rusk2ua/remkey/docs/remote-access-tailscale-nordvpn.md

# Remote access with Tailscale while NordVPN stays on

How to reach the shack PC from the road with **Tailscale**, while **NordVPN** keeps
running on the shack PC full time. It covers the shack PC (Windows 10), the Macs
and the iPad.

Short version:

- **AnyDesk** stays as the screen, keyboard and audio path. It already handles the
  shack PC's two displays and the 7610's USB audio, and nothing else here does that
  better.
- **Tailscale** carries remkey (TCP 7373) and gives you a private backup path to the
  shack PC. It replaces the router port-forward (section 5, Option A) and the
  AnyDesk TCP tunnel (Option B).
- **NordVPN** stays connected on the shack PC, with a few settings changed
  (section 3). Tailscale runs *inside* the NordVPN tunnel; do **not** exclude the
  Tailscale service with NordVPN's split tunneling (it cuts Tailscale off).
- **On the Macs and the iPad, Tailscale and NordVPN can't run at the same time.**
  Disconnect NordVPN before you connect to the station (section 7).

---

## 1. How the pieces fit

```
 Mac (NordVPN OFF)                                   Shack PC (NordVPN ON)
 ┌──────────────────┐                                ┌──────────────────────────────┐
 │ remkey.client ───┼── Tailscale (WireGuard) ──────►│ tailscaled  ──► remkey.station│
 │                  │   100.x.y.z : TCP 7373         │  (rides inside the  port 7373│
 │                  │                                │   NordVPN tunnel)            │
 │ AnyDesk ─────────┼── AnyDesk (as today) ─────────►│ AnyDesk: 2 displays + audio  │
 └──────────────────┘                                │                              │
                                                     │ browsers, updates, etc. ──►  │
                                                     │   NordVPN tunnel (unchanged) │
                                                     └──────────────────────────────┘
```

Why this works: Tailscale only routes traffic for its own `100.64.0.0/10`
addresses and leaves everything else to NordVPN, so the two don't fight over
routes. Tailscale's own encrypted packets simply travel through the NordVPN tunnel,
and the outside world sees the shack PC at a NordVPN server address. NordVPN's NAT
is the friendly kind (`tailscale netcheck` shows `MappingVariesByDestIP: false`),
so peers can usually still connect directly, with a detour through the NordVPN
server, instead of falling back to Tailscale's relays.

**Tested and rejected: excluding `tailscaled.exe` with NordVPN split tunneling.**
It looks like the obvious fix, but on this PC (NordVPN Windows app, Oct 2026) the
exclusion only takes effect when the Tailscale service restarts, and from then on
the service can't reach anything: `tailscale status` shows it logged out, unable to
fetch the control key ("A socket operation was attempted to an unreachable
network"). NordVPN's per-app exclusion is built for desktop apps, not a service
running as SYSTEM. Removing `tailscaled.exe` from the list and restarting the
service fixed it.

A side effect worth knowing: with NordVPN on, the old router port-forward
(Option A) probably never worked reliably, because replies to inbound connections
leave through the NordVPN tunnel instead of the Spectrum line. Tailscale avoids
that problem entirely, since every connection is outbound from both ends.

---

## 2. Shack PC: install and set up Tailscale

Do this while you're at home, sitting at the shack PC.

1. Run the Tailscale installer you downloaded. Sign in with the same account you
   used to sign up.
2. In the Tailscale tray menu, open **Preferences** (newer builds call it
   **Settings**) and turn on **Run unattended**. Without this, Tailscale stops when
   you're logged out, and an unattended shack PC needs it running from boot.
3. Make sure **Use exit node** is **None**, and leave **Run exit node** off. An
   exit node can't coexist with NordVPN.
4. Open the admin console (<https://login.tailscale.com/admin/machines>) on any
   computer:
   - Rename the shack PC to something short, e.g. `shack` (**…** menu →
     **Edit machine name**).
   - **…** menu → **Disable key expiry**. Otherwise the shack PC drops off the
     tailnet after 180 days and you can't fix it from the road.
   - Note its `100.x.y.z` address. It doesn't change, so the clients use it
     directly.
5. In PowerShell (no admin needed):
   ```
   tailscale status
   tailscale ip -4
   ```
   `status` should list the shack PC and any other devices you've added.

Tailscale sets its adapter to the **Private** network category in Windows. If the
tray ever shows *"Failed to set the network category to private"*, restart
Tailscale, and check that `tailscaled.exe` is *not* in NordVPN's split tunneling
list (section 3).

---

## 3. Shack PC: NordVPN settings

Open the NordVPN app → the **gear icon** (bottom left) → work down the list below.
Names move between app versions; if a setting isn't where this says, use the search
box at the top of NordVPN's settings.

| Setting | Where (Windows app) | Set to | Why |
|---|---|---|---|
| VPN protocol | Settings → Connection | **NordLynx** (already) | Leave as is. |
| Auto-connect | Settings → Connection (or General) | **On**, "Always" / "On all networks" | NordVPN comes back by itself after a reboot. |
| **Meshnet** | Varies by version | **Off** (check it with PowerShell; see below) | Meshnet uses the same `100.64.0.0/10` address block as Tailscale. Both on = address conflict. |
| **Kill Switch** | Settings → Kill Switch | **Internet Kill Switch: Off.** App Kill Switch: optional (browsers only) | If NordVPN ever drops with the Internet Kill Switch on, it blocks *all* traffic, Tailscale and AnyDesk included, and you're locked out until someone is at the PC. |
| **Split tunneling** | Settings → Split tunneling | Off, or on **without `tailscaled.exe`** in the list | Excluding the Tailscale service cuts it off entirely (section 1). |
| Threat Protection / custom DNS | Settings → Threat Protection, Settings → Connection | Either is fine | Can stop Tailscale names (MagicDNS) resolving *on the shack PC*. Nothing here relies on that: the clients use the 100.x address. |
| Stay invisible on LAN / Allow LAN discovery | Settings → Connection (or General) | Either is fine | Affects your home LAN, not the tailnet. |

### Checking and turning off Meshnet

NordVPN keeps moving Meshnet's controls between app versions (the 2026 redesign
shows only file-transfer options on the Meshnet screen), so check the network
adapter instead of the app. In PowerShell:

```powershell
Get-NetIPAddress -AddressFamily IPv4 |
  Where-Object IPAddress -like '100.*' |
  Format-Table InterfaceAlias, IPAddress
```

- **No rows** (before Tailscale is installed), or **one row on the Tailscale
  adapter**: Meshnet is off. Nothing to do.
- **A row on a NordLynx/NordVPN adapter**: Meshnet is active. Find its
  disable option in the app (older versions: the dropdown arrow next to the
  Meshnet toggle on **Devices in Meshnet** → **Disable for this device**; in
  newer versions try the search box in Settings), then run the check again.

### Checking Tailscale after NordVPN changes

After changing NordVPN settings, restart the Tailscale service (PowerShell as
Administrator) and check that it's still connected:

```powershell
Restart-Service Tailscale     # can look stuck for a while; it usually isn't
Start-Sleep 15
tailscale status
```

You should see your devices, with the shack PC on its `100.x` address. If it says
**logged out** and mentions the control key or an unreachable network, NordVPN is
blocking the service: take `tailscaled.exe` out of NordVPN's split tunneling list,
then restart the service again.

To see the public addresses the service is using:

```powershell
(tailscale status --json | ConvertFrom-Json).Self.Addrs
```

With NordVPN connected you'll see a NordVPN server address, the NordLynx address
(`10.5.0.x`) and the LAN address. That's expected. (`tailscale netcheck` runs from
the CLI process, so it reports what the CLI sees, not necessarily the service.)

### Plan B: only selected apps use NordVPN (untested here)

If tailnet connections from the road turn out to be relayed (`via DERP(...)`) and
the extra latency matters, NordVPN's split tunneling has a second mode, **"Enable
VPN for selected apps only"**: only the apps you list (your browsers, for
example) go through NordVPN, and everything else (Tailscale, AnyDesk, N1MM+,
Windows Update) uses the fiber directly. That avoids per-app exclusion of the
Tailscale service entirely. Test it with the commands above, and run the remote
reboot test in section 9 before relying on it.

---

## 4. remkey over Tailscale

**Why Tailscale Serve:** with NordVPN connected, NordVPN's firewall on the shack
PC drops *inbound* TCP connections arriving on the Tailscale adapter (ping still
works, but a connection to a program listening on the 100.x address hangs).
Tested: a Windows Firewall rule allowing 7373 from the tailnet is not enough, and
disconnecting NordVPN makes it work immediately. Tailscale Serve gets around this:
the Tailscale service (`tailscaled`) accepts the connection itself, which NordVPN
allows, and hands it to remkey over localhost.

### Shack PC

1. In `station.toml`, listen on localhost only:
   ```toml
   listen_host = "127.0.0.1"
   listen_port = 7373
   ```
   Nothing on the LAN or the internet can reach the port directly; only Serve can.
2. Restart the station service (or the Task Scheduler task).
3. PowerShell **as Administrator**:
   ```powershell
   tailscale serve --bg --tcp 7373 tcp://127.0.0.1:7373
   tailscale serve status
   ```
   If it prints a link to enable Serve for your tailnet, open it, approve, and run
   the command again. `--bg` makes it permanent (it survives reboots). The status
   should show `tcp://100.x.y.z:7373 (tailnet only)` → `tcp://127.0.0.1:7373`.
4. Check who's listening:
   ```powershell
   Get-NetTCPConnection -LocalPort 7373 -State Listen |
     Select-Object LocalAddress, @{n='Process';e={(Get-Process -Id $_.OwningProcess).ProcessName}}
   ```
   Expect `127.0.0.1` → `python` and `100.x.y.z` → `tailscaled`.
5. No Windows Firewall rule is needed for 7373. If Windows created *Allow* rules for
   `python.exe` / `py.exe` when the station first ran, you can disable them
   (`wf.msc` → Inbound Rules, sort by Program).
6. If you set up a **router port-forward** for 7373 (README Option A), delete it.

To turn it off: `tailscale serve --tcp=7373 off`.

### Mac

In `client.toml`:
```toml
station_host = "100.x.y.z"   # the shack PC's Tailscale address from section 2
station_port = 7373
```
(The MagicDNS name also works when NordVPN is off on the Mac, but the address has
no DNS dependence at all.)

Bonus: the remkey link is now encrypted end to end by Tailscale (WireGuard), which
closes the "traffic isn't encrypted" note in `SECURITY.md`.

---

## 5. AnyDesk: keep it for screen and audio

AnyDesk stays the primary way to see and drive the shack PC:

- **Dual displays:** AnyDesk shows the shack PC's real displays as they are. Windows
  Remote Desktop (RDP) instead builds a new desktop sized to your Mac's screen, so
  N1MM+, GH Everyware and the 7610 display window get rearranged every time you
  connect.
- **Audio:** the 7610's USB audio → "Listen to this device" → AnyDesk audio path
  (README section 6, "Audio") is already set up. RDP is known to hide or upset radio
  audio devices; FlexRadio DAX and WSJT-X users report the radio's sound devices
  disappearing over RDP.

**Dropped sessions (`anynet_unknown` every few minutes):** this predates Tailscale
here; it happens with NordVPN on the shack PC. What helps:

1. On the shack PC, AnyDesk → **Settings → Connection** → unlock → **untick
   "Allow direct connections"**. Sessions then always go through AnyDesk's relays,
   which NordVPN doesn't interrupt.
2. Connect with **`/np`** after the ID (e.g. `123456789/np`), which also helped
   before.
3. Last resort, and only while you're at the shack PC: add AnyDesk to NordVPN
   split tunneling (bypass). Test it the same way as section 3, because excluding
   the Tailscale *service* this way cut it off completely, and AnyDesk also runs
   as a service.

Otherwise nothing in AnyDesk has to change; connect by AnyDesk ID as usual (tested working
alongside remkey over Tailscale). Connecting AnyDesk to the shack PC's Tailscale
address instead would hit the same NordVPN inbound block as remkey (section 4),
so don't bother unless you also route it through Serve
(`tailscale serve --bg --tcp 7070 tcp://127.0.0.1:7070` with AnyDesk's direct
connections enabled; untested).

---

## 6. Backup path: Remote Desktop over Tailscale (emergency only)

If AnyDesk itself breaks while you're away (crashed, updated badly, account
problem), Tailscale still gives you a way in:

- **Needs Windows 10 Pro.** Check with **Settings → System → About → Edition**.
  Windows 10 Home can't accept Remote Desktop connections.
- On the shack PC: **Settings → System → Remote Desktop → On**, and add your Windows
  user if asked. Restrict the built-in firewall rules to the tailnet:
  ```powershell
  Get-NetFirewallRule -DisplayGroup "Remote Desktop" |
    Set-NetFirewallRule -RemoteAddress 100.64.0.0/10,fd7a:115c:a1e0::/48
  ```
- With NordVPN connected, inbound RDP over Tailscale is blocked the same way remkey
  was (section 4). Either route it through Serve on a separate port
  (`tailscale serve --bg --tcp 13389 tcp://127.0.0.1:3389`, then connect to
  `100.x.y.z:13389`; untested), or disconnect NordVPN first (which needs AnyDesk,
  the thing that's broken in this scenario). Test this at home before relying on
  it.
- On the Mac or iPad: Microsoft's **Windows App** (formerly Remote Desktop) →
  add PC → the shack PC's 100.x address.
- Expect: the shack PC's local monitors lock, the window layout gets rearranged,
  and radio audio may not work. Use it to restart AnyDesk (or reboot), then go back
  to AnyDesk.

---

## 7. Macs (M4 Pro MBP, M3 Air)

1. Install Tailscale (Mac App Store or the standalone download from tailscale.com)
   and sign in with the same account.
2. **macOS can't run Tailscale and NordVPN together.** With NordVPN connected, new
   connections to tailnet addresses time out even though Tailscale says it's
   connected. Tailscale's maintainers treat this as a macOS limitation (one VPN at a
   time), not a bug that will be fixed.
3. So, to operate:
   1. **Disconnect NordVPN** (and turn off its auto-connect on the Macs, or it will
      reconnect on a new Wi-Fi network mid-session).
   2. Connect Tailscale.
   3. Start AnyDesk and `remkey.client`.
4. You give up nothing important on hotel or club Wi-Fi: the remkey link (Tailscale)
   and AnyDesk are both encrypted end to end. Only your *other* browsing loses
   NordVPN's cover while you operate.
5. If you want full-tunnel privacy *and* the tailnet at the same time, Tailscale's
   Mullvad exit-node add-on does that (paid, per 5 devices). It replaces NordVPN on
   the Mac rather than running alongside it. Not needed for station use.

## 8. iPad

iPadOS allows one VPN at a time, so it's Tailscale or NordVPN, never both. Since
you rarely run a VPN on the iPad, just install Tailscale and AnyDesk from the App
Store. remkey's client is Mac-only, so the iPad is for watching, tuning and
logging, not paddle CW.

---

## 8a. Other station software (N1MM+, GH Everyware, Slack)

Tailscale on the shack PC only adds routes for `100.64.0.0/10` and
`fd7a:115c:a1e0::/48`. Default internet traffic still goes through NordVPN, and
LAN traffic (`192.168.x.x`) still goes out the Ethernet adapter, so programs that
worked with NordVPN keep working:

- **Outbound internet clients** (Slack, cluster/telnet spots, callbook lookups,
  updates) are unchanged: still through NordVPN.
- **LAN and localhost** (N1MM+ to GH Everyware on 127.0.0.1, multi-computer N1MM+
  on the home LAN, the rotator controller) are unchanged.
- **Windows Firewall:** the only change is the disabled `python.exe` allow rules. If some *other* Python program on
  this PC accepts inbound connections from the LAN, give it its own rule.

What to check once, after a reboot:

1. `route print -4` → two `0.0.0.0` default routes: the NordLynx one
   (gateway `10.5.0.1`) with a much lower metric than the Ethernet one, so it
   wins. The Tailscale adapter (`100.x`) should only carry one `/32` route per
   tailnet peer plus `100.100.100.100` (MagicDNS), and no broadcast
   (`255.255.255.255`) or multicast (`224.0.0.0`) routes, so LAN broadcasts
   from N1MM+ never go near it.
2. **N1MM+**: if you use multi-computer networking or UDP broadcasts, confirm it's
   still using the LAN address (192.168.x.x), not the `100.x` Tailscale address.
   Programs that pick "the first network adapter" can grab the new one.
3. **GH Everyware** connects to the rotator and N1MM+ as before.

Adding remote computers later (a second N1MM+ station, a laptop in the field):
put them on the tailnet instead of opening ports on the router, and give N1MM+
their `100.x` addresses explicitly. Tailscale carries unicast traffic but not LAN
broadcasts, so anything that relies on broadcast discovery needs the address typed
in. If a Tailscale DNS setting ever interferes with name lookups,
`tailscale set --accept-dns=false` on the shack PC turns that part off without
affecting anything else.

## 9. Test before you leave home

Do these **at home**, with the Mac on the **phone hotspot** (not home Wi-Fi), so
you're testing the real path.

- [ ] Shack PC: NordVPN connected, `tailscale status` shows the Mac.
- [ ] Mac (NordVPN off): `tailscale ping 100.x.y.z` → replies. Ending
      `via <NordVPN server IP>:<port>` is direct (with the NordVPN detour);
      `via DERP(...)` means relayed: works, but slower (see Plan B, section 3).
      `tailscale ping` stops as soon as it finds a direct path, whatever `-c`
      says; add `--until-direct=false` to keep pinging.

      Measured here (Oct 2026, iPhone on cellular): with NordVPN connected on
      the shack PC, every ping went via DERP(nyc) at roughly 90–170 ms; with
      NordVPN disconnected it went direct at roughly 80–110 ms. So NordVPN does
      force the relay, but on cellular the difference is a few tens of ms,
      which doesn't matter for remkey.
- [ ] Mac: `nc -vz -w 5 100.x.y.z 7373` → `succeeded`, **with NordVPN connected
      on the shack PC**. A hang (timeout) means Serve isn't set up (section 4).
- [ ] Mac: `remkey.client` connects; the station log shows the login. Key with
      `--dry-run` on the station first.
- [ ] AnyDesk session works as before, both displays and audio.
- [ ] **Reboot the shack PC remotely** (Start → Restart from AnyDesk) and confirm
      that, without touching it, NordVPN reconnects, Tailscale comes back, the
      remkey task starts after login, and AnyDesk reconnects.
- [ ] Disconnect NordVPN on the shack PC briefly: Tailscale and AnyDesk should keep
      working (this proves the kill switch is off).
- [ ] Optional: Remote Desktop to the 100.x address works (section 6).

---

## 10. Troubleshooting

| Symptom | Likely cause | Fix |
|---|---|---|
| Mac: Tailscale "Connected", but nothing on the tailnet answers | NordVPN connected on the Mac | Disconnect NordVPN on the Mac (section 7). |
| `tailscale ping` works, `nc` to 7373 hangs/times out | NordVPN blocking inbound on the Tailscale adapter | Use Tailscale Serve (section 4); check `tailscale serve status`. |
| `nc` to 7373 is refused right away | Station service not running, or not on 127.0.0.1 | Check the station console/log and `Get-NetTCPConnection -LocalPort 7373`. |
| `tailscale ping` goes via DERP every time | NAT traversal through the NordVPN server failing | Works, just slower. If it matters, try Plan B (section 3). |
| Shack PC: `tailscale status` says logged out, "fetch control key … unreachable network" | `tailscaled.exe` excluded in NordVPN split tunneling | Remove it from the list, `Restart-Service Tailscale`. |
| Shack PC drops off the tailnet entirely | Key expiry, or Tailscale not running unattended | Section 2 steps 2 and 4. |
| Shack PC unreachable by anything after a NordVPN hiccup | Internet Kill Switch on | Turn it off (section 3). |
| Tailscale shows a Meshnet/address warning, or tailnet traffic goes nowhere | NordVPN Meshnet turned on | Turn Meshnet off. |
| Still unreachable with everything above checked | NordVPN's firewall blocking the tailnet anyway | Plan B in section 3 ("Enable VPN for selected apps only"). |

## What not to do

- Don't make the shack PC a Tailscale **exit node** or **subnet router**; both need
  their own aggressive routing that collides with NordVPN.
- Don't turn on NordVPN **Meshnet** on any device that runs Tailscale.
- Don't change Tailscale's address range or switch it to userspace mode to "fix"
  NordVPN; neither addresses the actual problem (NordVPN's firewall).

## References

- Tailscale: [Can I use Tailscale alongside other VPNs?](https://tailscale.com/kb/1105/other-vpns)
- Tailscale: [Windows network category message](https://tailscale.com/docs/reference/messages/client/set-network-category-failed)
- Tailscale issue [#21248](https://github.com/tailscale/tailscale/issues/21248): macOS tailnet TCP fails while NordVPN is connected
- NordVPN: [Split tunneling](https://support.nordvpn.com/hc/en-us/articles/19618692366865-What-is-Split-Tunneling-and-how-to-use-it)
- Home Assistant community: [Tailscale + NordVPN on Windows via split tunneling](https://community.home-assistant.io/t/accessing-ha-on-win11-with-both-nordvpn-and-tailscale-active/1010677)
- AnyDesk: [Client settings (direct connections)](https://support.anydesk.com/docs/settings)
