rusk2ua/remkey/host/remkey/station.py

"""remkey station service: runs on the shack PC next to N1MM+.

    python -m remkey.station --config station.toml

Accepts one authenticated client at a time and drives the station Nano:
text -> "T:", PTT -> "P:", speed -> "W:". If the client goes quiet or
disconnects, PTT is dropped and queued text is flushed. Independently, the
Nano's own watchdog drops PTT if this service stops talking to it.
"""

from __future__ import annotations

import argparse
import asyncio
import logging
import sys
import time
from collections import deque

from . import protocol as P
from .config import StationConfig, load_station
from .dashboard import Dashboard, Extremes, History
from .serial_link import BACK, LOST, FakeLink, KeyerLink, SerialLink
from .telemetry import (
    SRC_BASE,
    CableFit,
    Calibration,
    CsvLog,
    LinkStats,
    Packet,
    PowerPacket,
    ReplyAssembler,
    ReplyPart,
    gauge_match,
    parse_any,
)

log = logging.getLogger("remkey.station")


class Session:
    def __init__(self, reader: asyncio.StreamReader, writer: asyncio.StreamWriter):
        self.reader = reader
        self.writer = writer
        self.peer = writer.get_extra_info("peername")

    async def send(self, msg: dict) -> None:
        try:
            self.writer.write(P.encode(msg))
            await self.writer.drain()
        except (ConnectionError, RuntimeError):
            pass

    def send_nowait(self, msg: dict) -> None:
        try:
            self.writer.write(P.encode(msg))
        except (ConnectionError, RuntimeError):
            pass


class TelemetryHub:
    """Turns remtlm packets from the base Nano into calibrated readings and alerts.

    Two senders share the LoRa channel: the tower-top box ($RT, $RK and, if it has
    its own INA226, $RP) and the supply box at the tower base ($RS). Each has its
    own link statistics and stale alert.
    """

    def __init__(self, cfg: StationConfig, notify):
        self.cfg = cfg
        self.notify = notify                 # callable(dict): send to the client if connected
        self.pa_cal = Calibration(cfg.pa_cal)
        self.xv_cal = Calibration(cfg.xv_cal)
        self.stats = LinkStats()
        self.csv = CsvLog(cfg.tlm_csv) if cfg.tlm_csv else None
        self.latest: dict | None = None
        self.replies = ReplyAssembler()
        self.xv_replies: dict[str, dict] = {}     # "s"/"v" -> {"text", "time"}
        self.lock_ok = True
        self.hot = [False, False]
        self.stale = True
        names = list(cfg.temp_names) + ["probe 1", "probe 2"]
        self.temp_names = [str(names[0]), str(names[1])]
        self.pwr: PowerPacket | None = None          # latest top-box $RP, scaled
        self.pwr_time = 0.0
        self.box: PowerPacket | None = None          # latest supply-box $RS, scaled
        self.box_time = 0.0
        self.box_stats = LinkStats()
        self.box_stale = True
        self.box_hot = False
        self.fit = CableFit()                        # needs top-box voltage
        self.pwr_flags: dict[str, bool] = {}
        # for the web dashboard
        self.alerts: deque[dict] = deque(maxlen=200)
        self.on_alert = None                          # callable(dict), set by the dashboard
        self.extremes = Extremes()
        self.history = History(cfg.dash_history_h)
        self.history.pa_unit = "W" if self.pa_cal else "mV"
        if cfg.dash_port and cfg.tlm_csv:
            try:
                n = self.history.seed_from_csv(cfg.tlm_csv)
                if n:
                    log.info("dashboard: loaded %d rows of history from %s", n, cfg.tlm_csv)
            except (OSError, ValueError) as exc:
                log.warning("dashboard: could not read history from %s: %s", cfg.tlm_csv, exc)

    def on_line(self, line: str) -> None:
        p = parse_any(line)
        if isinstance(p, ReplyPart):
            self._on_reply(p)
            return
        if isinstance(p, PowerPacket):
            self._on_power(p)
            return
        if not isinstance(p, Packet):
            if line.startswith(("V:", "C:")):
                log.info("telemetry base: %s", line)
            elif line.startswith("E:"):
                log.warning("telemetry base: %s", line)
            return
        self.stats.update(p)
        pa_pk_w = self.pa_cal.watts(p.pa_pk_mv)
        pa_avg_w = self.pa_cal.watts(p.pa_avg_mv)
        top = self.pwr if (self.pwr is not None and self.pwr.seq == p.seq) else None
        box = self.box if (self.box is not None and not self.box_stale) else None
        self._csv(p, pa_pk_w, pa_avg_w, box or top, top if box else None)
        self.latest = {
            "t": "tlm",
            "seq": p.seq,
            "pa_pk_mv": p.pa_pk_mv,
            "pa_avg_mv": p.pa_avg_mv,
            "pa_pk_w": pa_pk_w,
            "pa_avg_w": pa_avg_w,
            "xv_pk_mv": p.xv_pk_mv,
            "xv_pk_w": self.xv_cal.watts(p.xv_pk_mv),
            "lock": p.lock,
            "temp_c": p.temp_c,
            "temp2_c": p.temp2_c,
            "temp_names": self.temp_names,
            "uptime_s": p.uptime_s,
            "loss_pct": round(self.stats.loss_pct_5min(), 1),
        }
        now = time.time()
        pa_pk = pa_pk_w if pa_pk_w is not None else p.pa_pk_mv
        pa_avg = pa_avg_w if pa_avg_w is not None else p.pa_avg_mv
        self.history.add_tower(now, pa_pk, pa_avg, p.xv_pk_mv, p.lock, p.temp_c, p.temp2_c)
        self.extremes.add("pa_pk", pa_pk)
        self.extremes.add("t1", p.temp_c)
        self.extremes.add("t2", p.temp2_c)
        if self.stale:
            self.stale = False
            self._alert("ok", "tower telemetry link up")
        if p.lock is not None and p.lock != self.lock_ok:
            self.lock_ok = p.lock
            self._alert("ok" if p.lock else "warn",
                        "10 MHz reference locked" if p.lock else "10 MHz reference UNLOCKED")
        for i, (t, warn) in enumerate(((p.temp_c, self.cfg.temp_warn_c),
                                       (p.temp2_c, self.cfg.temp2_warn_c))):
            if t is None:
                continue
            name = self.temp_names[i]
            if not self.hot[i] and t >= warn:
                self.hot[i] = True
                self._alert("warn", f"{name} HOT: {t:.1f} C")
            elif self.hot[i] and t < warn - 3:
                self.hot[i] = False
                self._alert("ok", f"{name} back to {t:.1f} C")
        self.notify(self.latest)

    # ------------------------------------------------------------ supply monitor
    def _csv(self, p, pa_pk_w, pa_avg_w, pwr, top) -> None:
        if not self.csv:
            return
        try:
            self.csv.write(p, pa_pk_w, pa_avg_w, pwr, top)
        except OSError as exc:
            log.warning("telemetry CSV: %s", exc)

    def _on_power(self, raw: PowerPacket) -> None:
        cfg = self.cfg
        p = raw.scaled(cfg.v_scale, cfg.i_scale)
        if p.src == SRC_BASE:
            self._on_box(p)
            return
        self.pwr = p
        self.pwr_time = time.time()
        self._flag("dead:top", not p.ok, "tower-top supply monitor (INA226) not answering",
                   "tower-top supply monitor answering again")
        if not p.ok:
            return
        self.history.add_top(self.pwr_time, p)
        self.extremes.add("top_v", p.v_min, p.v_max)
        self.fit.add(p.i_avg, p.v_avg)
        self._voltage_alerts(p, "tower-top supply", "top")
        if self.box is None or self.box_stale:       # the base box measures current when it's there
            self._current_alerts(p)
        self.notify(self.power_message())

    def _on_box(self, p: PowerPacket) -> None:
        cfg = self.cfg
        self.box_stats.update(p)
        self.box = p
        self.box_time = time.time()
        self.history.add_supply(self.box_time, p)
        self.extremes.add("box_temp", p.temp_c)
        if p.ok:
            self.extremes.add("v", p.v_min, p.v_max)
            self.extremes.add("i", p.i_min, p.i_max)
        if self.box_stale:
            self.box_stale = False
            self._alert("ok", "tower-base supply box link up")
        t = p.temp_c
        if t is not None and cfg.box_temp_warn_c:
            if not self.box_hot and t >= cfg.box_temp_warn_c:
                self.box_hot = True
                self._alert("warn", f"{cfg.box_temp_name} HOT: {t:.1f} C")
            elif self.box_hot and t < cfg.box_temp_warn_c - 3:
                self.box_hot = False
                self._alert("ok", f"{cfg.box_temp_name} back to {t:.1f} C")
        self._flag("dead:base", not p.ok, "tower-base supply monitor (INA226) not answering",
                   "tower-base supply monitor answering again")
        if self.stale:                               # no tower rows to ride on: log on our own
            self._csv(None, None, None, p, None)
        if not p.ok:
            return
        self._voltage_alerts(p, "supply at tower base", "base")
        self._current_alerts(p)
        self.notify(self.power_message())

    def _voltage_alerts(self, p: PowerPacket, where: str, key: str) -> None:
        cfg = self.cfg
        if cfg.v_min_alert:
            low = self.pwr_flags.get(f"low:{key}", False)
            self._flag(f"low:{key}", p.v_min < (cfg.v_min_alert + 0.2 if low else cfg.v_min_alert),
                       f"{where} LOW: {p.v_min:.2f} V (at up to {p.i_max:.2f} A)",
                       f"{where} back to {p.v_min:.2f} V")
        if cfg.v_max_alert:
            high = self.pwr_flags.get(f"high:{key}", False)
            self._flag(f"high:{key}", p.v_max > (cfg.v_max_alert - 0.2 if high else cfg.v_max_alert),
                       f"{where} HIGH: {p.v_max:.2f} V", f"{where} back to {p.v_max:.2f} V")

    def _current_alerts(self, p: PowerPacket) -> None:
        cfg = self.cfg
        if cfg.i_max_alert:
            on = self.pwr_flags.get("imax", False)
            self._flag("imax", p.i_max > (cfg.i_max_alert * 0.95 if on else cfg.i_max_alert),
                       f"tower current HIGH: {p.i_max:.2f} A peak (limit {cfg.i_max_alert:.2f} A)",
                       f"tower current back to {p.i_max:.2f} A peak")
        if cfg.i_min_alert:
            on = self.pwr_flags.get("imin", False)
            self._flag("imin", p.i_avg < (cfg.i_min_alert * 1.05 if on else cfg.i_min_alert),
                       f"tower current LOW: {p.i_avg:.2f} A (expected at least {cfg.i_min_alert:.2f} A)",
                       f"tower current back to {p.i_avg:.2f} A")

    def _flag(self, key: str, active: bool, warn_msg: str, ok_msg: str) -> None:
        was = self.pwr_flags.get(key, False)
        if active and not was:
            self.pwr_flags[key] = True
            self._alert("warn", warn_msg)
        elif not active and was:
            self.pwr_flags[key] = False
            self._alert("ok", ok_msg)

    def power_message(self, detail: bool = False) -> dict:
        """Supply summary for the client.

        Uses the base box when it is reporting, else the top-box INA226. With both,
        drop_v is measured (base minus top); with only the top box it is against
        base_supply_v from the config; with only the base box it is unknown (None).
        """
        now = time.time()
        box = self.box if (self.box is not None and not self.box_stale) else None
        top = self.pwr if (self.pwr is not None and now - self.pwr_time <= self.cfg.tlm_stale_s) else None
        p = box or top or self.box or self.pwr
        if p is None:
            return {"t": "pwr", "ok": False, "none": True}
        at = p.src
        msg = {"t": "pwr", "ok": p.ok, "at": at, "v_avg": p.v_avg, "v_min": p.v_min, "v_max": p.v_max,
               "i_avg": p.i_avg, "i_min": p.i_min, "i_max": p.i_max,
               "age_s": round(now - (self.box_time if p is self.box else self.pwr_time))}
        if at == SRC_BASE:
            ok_top = top is not None and top.ok
            msg.update({"base_v": p.v_avg, "top_v": top.v_avg if ok_top else None,
                        "drop_v": p.v_avg - top.v_avg if ok_top else None,
                        "box_temp_c": p.temp_c, "box_temp_name": self.cfg.box_temp_name,
                        "box_loss_pct": round(self.box_stats.loss_pct_5min(), 1),
                        "box_stale": self.box_stale})
        else:
            msg.update({"base_v": self.cfg.base_supply_v, "top_v": p.v_avg,
                        "drop_v": self.cfg.base_supply_v - p.v_avg})
        if detail:
            msg["query"] = True
            fit = self.fit.result()
            if fit:
                awg, exp, verdict = gauge_match(fit["r_ohm"], self.cfg.cable_one_way_ft)
                fit.update({"awg": awg, "expected_r": exp, "verdict": verdict,
                            "one_way_ft": self.cfg.cable_one_way_ft})
            msg["fit"] = fit
            msg["fit_points"] = len(self.fit.pts)
            msg["fit_possible"] = self.pwr is not None    # needs a top-box INA226
        return msg

    def _on_reply(self, rp: ReplyPart) -> None:
        done = self.replies.add(rp)
        if done is None:
            return
        cmd, text = done
        self.xv_replies[cmd] = {"text": text, "time": time.time()}
        log.info("transverter '%s' reply: %s", cmd, text.replace("\n", " | "))
        self.notify(self.xv_message(cmd))

    def xv_message(self, cmd: str) -> dict:
        r = self.xv_replies.get(cmd)
        if r is None:
            return {"t": "xvstat", "cmd": cmd, "text": None, "age_s": None}
        return {"t": "xvstat", "cmd": cmd, "text": r["text"], "age_s": round(time.time() - r["time"])}

    def check_stale(self) -> None:
        age = self.stats.age_s()
        if not self.stale and (age is None or age > self.cfg.tlm_stale_s):
            self.stale = True
            self._alert("warn", f"tower telemetry lost (no packet for {self.cfg.tlm_stale_s:.0f} s)")
        age = self.box_stats.age_s()
        if not self.box_stale and (age is None or age > self.cfg.tlm_stale_s):
            self.box_stale = True
            self._alert("warn", f"tower-base supply box lost (no packet for {self.cfg.tlm_stale_s:.0f} s)")

    def snapshot(self) -> dict | None:
        if self.latest is None:
            return None
        snap = dict(self.latest)
        snap["age_s"] = round(self.stats.age_s() or 0.0, 1)
        snap["stale"] = self.stale
        return snap

    def _alert(self, level: str, msg: str) -> None:
        (log.warning if level == "warn" else log.info)("telemetry: %s", msg)
        self.notify({"t": "alert", "level": level, "msg": msg})
        a = {"ts": time.time(), "level": level, "msg": msg}
        self.alerts.append(a)
        if self.on_alert:
            self.on_alert(a)

    def mark(self, text: str, peer: str = "") -> None:
        """A note from the dashboard ("starting TX test"): goes to the log, the alert list and the client."""
        log.info("dashboard marker from %s: %s", peer or "?", text)
        self._alert("info", f"MARK: {text}")


class StationService:
    def __init__(self, cfg: StationConfig, link: KeyerLink, tlm_link: KeyerLink | None = None):
        self.cfg = cfg
        self.link = link
        self.tlm_link = tlm_link
        self.tlm = TelemetryHub(cfg, self._notify) if tlm_link is not None else None
        self.session: Session | None = None
        self.ptt = False
        self.releasing = False          # PTT off requested; station finishing CW + hang
        self.wpm = 18
        self.server: asyncio.base_events.Server | None = None
        self._hb_task: asyncio.Task | None = None
        self.dashboard: Dashboard | None = None
        self.cloud = None
        link.set_handler(self._on_keyer_line)
        if tlm_link is not None:
            tlm_link.set_handler(self.tlm.on_line)

    # ------------------------------------------------------------ lifecycle
    def _init_keyer(self) -> None:
        self.link.send("G:1")          # make sure the Nano watchdog is armed
        self.link.send(f"J:{max(0, min(10000, int(self.cfg.ptt_hang_ms)))}")
        self.link.send("O")            # PTT off and nothing queued, right now
        self.link.send("V")

    async def start(self) -> None:
        self._init_keyer()
        self.server = await asyncio.start_server(
            self._handle_client, self.cfg.listen_host, self.cfg.listen_port, limit=P.MAX_LINE
        )
        self._hb_task = asyncio.create_task(self._keyer_heartbeat())
        addrs = ", ".join(str(s.getsockname()) for s in self.server.sockets)
        log.info("listening on %s", addrs)
        if self.cfg.dash_port:
            dash = Dashboard(self, self.cfg.dash_host, self.cfg.dash_port, self.cfg.dash_allow,
                             self.cfg.dash_hostnames)
            try:
                await dash.start()
            except OSError as exc:     # port in use etc.: keying must still come up
                log.error("dashboard not started on port %s: %s", self.cfg.dash_port, exc)
            else:
                self.dashboard = dash
                if self.tlm:
                    self.tlm.on_alert = dash.push_alert
        if self.cfg.cloud_bucket:
            from .cloud import CloudUploader
            self.cloud = CloudUploader(self)
            self.cloud.start()

    @property
    def port(self) -> int:
        assert self.server is not None
        return self.server.sockets[0].getsockname()[1]

    async def stop(self) -> None:
        self._safe_off("service stopping")
        if self._hb_task:
            self._hb_task.cancel()
        if self.dashboard:
            await self.dashboard.stop()
        if self.cloud:
            await self.cloud.stop()
        if self.server:
            self.server.close()
            await self.server.wait_closed()

    async def _keyer_heartbeat(self) -> None:
        while True:
            self.link.send("H")
            if self.tlm:
                self.tlm.check_stale()
            await asyncio.sleep(1.0)

    def _notify(self, msg: dict) -> None:
        if self.session:
            self.session.send_nowait(msg)

    # ------------------------------------------------------------ safety
    def _safe_off(self, why: str) -> None:
        """Safety stop: abort CW and drop PTT immediately (no release hang)."""
        if self.ptt:
            log.warning("PTT off: %s", why)
        self.link.send("O")
        self.ptt = False
        self.releasing = False

    # ------------------------------------------------------------ keyer events
    def _on_keyer_line(self, line: str) -> None:
        s = self.session
        if line == "D":
            if s:
                s.send_nowait({"t": "drained"})
        elif line in ("P:0", "P:1"):
            # the Nano reports every actual change of its PTT output
            on = line == "P:1"
            if on:
                # Don't touch `releasing`: this report can arrive after a release was
                # already requested (PTT on then off in quick succession).
                self.ptt = True
            else:
                if self.ptt or self.releasing:
                    log.info("PTT off (released after queued CW and hang)" if self.releasing
                             else "PTT off")
                self.ptt = False
                self.releasing = False
            if s:
                s.send_nowait(self._state())
        elif line == LOST:
            # USB unplugged: the Nano is unpowered, so both optos are already open
            log.warning("station keyer USB disconnected: PTT and KEY are off")
            self.ptt = False
            self.releasing = False
            if s:
                s.send_nowait({"t": "log", "msg": "keyer USB disconnected - PTT is off"})
                s.send_nowait(self._state())
        elif line == BACK:
            log.warning("station keyer reconnected")
            self._init_keyer()
            self.link.send(f"W:{min(50, self.wpm + self.cfg.wpm_offset)}")
            if s:
                s.send_nowait({"t": "log", "msg": "keyer reconnected"})
        elif line.startswith("!:"):
            log.warning("keyer watchdog: %s", line)
            self.ptt = False
            self.releasing = False
            if s:
                s.send_nowait({"t": "wdog", "why": "station keyer watchdog"})
                s.send_nowait(self._state())
        elif line.startswith("K:"):
            # someone is using a paddle plugged into the station Nano
            log.info("station paddle: %r", line[2:])
        elif line.startswith("V:"):
            log.info("keyer: %s", line[2:])
        elif line.startswith("E:"):
            log.warning("keyer error: %s", line)
            if s:
                s.send_nowait({"t": "log", "msg": f"keyer {line}"})
        else:
            log.debug("keyer: %s", line)

    def _state(self) -> dict:
        return {"t": "state", "ptt": self.ptt, "releasing": self.releasing, "wpm": self.wpm,
                "hang_ms": self.cfg.ptt_hang_ms}

    # ------------------------------------------------------------ clients
    async def _handle_client(self, reader: asyncio.StreamReader, writer: asyncio.StreamWriter) -> None:
        sess = Session(reader, writer)
        if self.session is not None:
            log.warning("rejecting %s: another client is connected", sess.peer)
            await sess.send({"t": "err", "msg": "busy: another client is connected"})
            writer.close()
            return

        nonce = P.make_nonce()
        await sess.send({"t": "hello", "v": P.PROTOCOL_VERSION, "nonce": nonce})
        try:
            line = await asyncio.wait_for(reader.readline(), timeout=10.0)
            msg = P.decode(line)
        except Exception:  # noqa: BLE001  (timeout, bad JSON, oversize)
            log.warning("handshake failed from %s", sess.peer)
            writer.close()
            return
        if msg.get("t") != "auth" or not P.verify_mac(self.cfg.secret, nonce, msg.get("mac")):
            log.warning("bad auth from %s", sess.peer)
            await sess.send({"t": "err", "msg": "auth failed"})
            writer.close()
            return
        if self.session is not None:          # raced with another client during handshake
            await sess.send({"t": "err", "msg": "busy: another client is connected"})
            writer.close()
            return

        self.session = sess
        log.info("client connected: %s", sess.peer)
        await sess.send({"t": "ok"})
        await sess.send(self._state())
        if self.tlm:
            snap = self.tlm.snapshot()
            if snap:
                await sess.send(snap)
        why = "client disconnected"
        try:
            while True:
                try:
                    line = await asyncio.wait_for(reader.readline(), timeout=self.cfg.heartbeat_timeout_s)
                except TimeoutError:
                    why = "heartbeat lost"
                    await sess.send({"t": "wdog", "why": "station lost heartbeat"})
                    break
                if not line:
                    break
                try:
                    msg = P.decode(line)
                except ValueError:
                    await sess.send({"t": "err", "msg": "bad message"})
                    continue
                await self._dispatch(sess, msg)
        except (ConnectionError, asyncio.IncompleteReadError, asyncio.LimitOverrunError, ValueError):
            why = "connection error"
        finally:
            self._safe_off(why)
            self.session = None
            log.info("client gone (%s): %s", why, sess.peer)
            try:
                writer.close()
            except Exception:  # noqa: BLE001
                pass

    async def _dispatch(self, sess: Session, msg: dict) -> None:
        t = msg.get("t")
        if t == "hb":
            await sess.send({"t": "hb", "ts": msg.get("ts")})
        elif t == "cw":
            text = P.sanitize_cw(str(msg.get("text", "")), self.cfg.max_text_chars)
            for chunk in P.chunk_for_keyer(text):
                self.link.send("T:" + chunk)
        elif t == "ptt":
            if msg.get("on"):
                self.link.send("P:1")      # also cancels a release in progress
                self.ptt = True
                self.releasing = False
                log.info("PTT ON")
            elif self.ptt and not self.releasing:
                # graceful: the Nano keys out whatever is queued, holds PTT for the
                # hang time (restarted by any CW that arrives), then reports P:0
                self.link.send("P:0")
                self.releasing = True
                log.info("PTT release requested: finishing queued CW, then %d ms hang",
                         self.cfg.ptt_hang_ms)
            await sess.send(self._state())
        elif t == "wpm":
            try:
                v = max(5, min(50, int(msg.get("v"))))
            except (TypeError, ValueError):
                return
            self.wpm = v
            self.link.send(f"W:{min(50, v + self.cfg.wpm_offset)}")
            await sess.send(self._state())
        elif t == "tune":
            try:
                ms = max(0, min(self.cfg.max_tune_ms, int(msg.get("ms"))))
            except (TypeError, ValueError):
                return
            if not self.ptt or self.releasing:
                await sess.send({"t": "log", "msg": "tune ignored: PTT is off"})
                return
            self.link.send(f"U:{ms}")
        elif t == "abort":
            if self.releasing:
                # Esc during a release: stop now rather than wait out the hang
                self._safe_off("abort during PTT release")
                await sess.send(self._state())
            else:
                self.link.send("X")
        elif t == "tlmq":
            snap = self.tlm.snapshot() if self.tlm else None
            await sess.send(snap or {"t": "log", "msg": "no tower telemetry"})
        elif t == "pwrq":
            if not self.tlm:
                await sess.send({"t": "log", "msg": "no tower telemetry"})
            else:
                await sess.send(self.tlm.power_message(detail=True))
        elif t == "xvq":
            if not self.tlm:
                await sess.send({"t": "log", "msg": "no tower telemetry"})
            else:
                msg = self.tlm.xv_message("s")
                msg["version"] = (self.tlm.xv_replies.get("v") or {}).get("text")
                msg["query"] = True
                await sess.send(msg)
        else:
            await sess.send({"t": "err", "msg": f"unknown type {t!r}"})


async def _amain(cfg: StationConfig, dry_run: bool) -> None:
    loop = asyncio.get_running_loop()
    link: KeyerLink = FakeLink() if dry_run else SerialLink(cfg.keyer_port, cfg.keyer_baud, loop)
    tlm_link: KeyerLink | None = None
    if cfg.tlm_port and not dry_run:
        tlm_link = SerialLink(cfg.tlm_port, cfg.tlm_baud, loop)
    svc = StationService(cfg, link, tlm_link)
    await svc.start()
    try:
        await asyncio.Event().wait()
    finally:
        await svc.stop()
        link.close()
        if tlm_link:
            tlm_link.close()


def _disable_quickedit() -> None:
    """Windows: turn off QuickEdit for this console window.

    With QuickEdit on, a stray click in the window starts a text selection, and
    Windows then blocks the process on its next console write: the service stops
    answering clients and stops sending keyer heartbeats until the selection is
    cleared. Harmless no-op when stdin isn't a console (or not Windows).
    """
    if sys.platform != "win32":
        return
    try:
        import ctypes

        k32 = ctypes.windll.kernel32
        h = k32.GetStdHandle(-10)                     # STD_INPUT_HANDLE
        mode = ctypes.c_uint32()
        if not k32.GetConsoleMode(h, ctypes.byref(mode)):
            return
        ENABLE_QUICK_EDIT_MODE, ENABLE_EXTENDED_FLAGS = 0x0040, 0x0080
        k32.SetConsoleMode(h, (mode.value & ~ENABLE_QUICK_EDIT_MODE) | ENABLE_EXTENDED_FLAGS)
    except Exception:  # noqa: BLE001
        pass


def main(argv: list[str] | None = None) -> int:
    ap = argparse.ArgumentParser(description="remkey station service")
    ap.add_argument("--config", default="station.toml")
    ap.add_argument("--dry-run", action="store_true", help="no Nano; log keyer commands only")
    ap.add_argument("-v", "--verbose", action="store_true")
    args = ap.parse_args(argv)
    _disable_quickedit()

    cfg = load_station(args.config)
    handlers: list[logging.Handler] = [logging.StreamHandler(sys.stdout)]
    if cfg.log_file:
        handlers.append(logging.FileHandler(cfg.log_file, encoding="utf-8"))
    logging.basicConfig(
        level=logging.DEBUG if args.verbose else logging.INFO,
        format="%(asctime)s %(levelname)-7s %(message)s",
        handlers=handlers,
    )
    try:
        asyncio.run(_amain(cfg, args.dry_run))
    except KeyboardInterrupt:
        pass
    return 0


if __name__ == "__main__":
    sys.exit(main())
