rusk2ua/remkey/tests/firmware_sim/tlm_proto_test.cpp

// Checks tlm_proto.h and prints sample packets for the Python cross-check
// (host/tests/test_telemetry.py compiles and runs this if g++ is available).
#include "tlm_proto.h"
#include <cstdio>

int main() {
  int fails = 0;
  char buf[TLM_MAX_LINE];
  TlmData d = {65535, 4987, 1234, 0, 1, 452, 318, 86400UL, "K2UA"};
  if (tlmFormat(buf, sizeof(buf), &d) <= 0) { std::printf("FAIL format\n"); return 1; }
  std::printf("%s", buf);
  d = {7, 0, 0, 2500, 0, TLM_TEMP_NONE, TLM_TEMP_NONE, 3, "K2UA"};
  tlmFormat(buf, sizeof(buf), &d);
  std::printf("%s", buf);
  d = {8, 100, 50, 0, 2, -105, 0, 4, "K2UA"};   // -10.5 C, lock monitoring off
  tlmFormat(buf, sizeof(buf), &d);
  std::printf("%s", buf);

  // supply monitor packet, including a negative current (reversed shunt)
  PwrData pw = {42, 13284, 12851, 13402, 4012, 3900, 6104, 1, "K2UA"};
  if (tlmFormatPower(buf, sizeof(buf), &pw) <= 0) { fails++; std::printf("FAIL power format\n"); }
  std::printf("%s", buf);
  pw = {43, 14100, 14100, 14100, -512, -40960, 40959, 1, "K2UA"};
  tlmFormatPower(buf, sizeof(buf), &pw);
  std::printf("%s", buf);
  {
    char chk[TLM_MAX_LINE];
    memcpy(chk, buf, sizeof(chk));
    chk[strcspn(chk, "\r\n")] = 0;
    if (!tlmValid(chk)) { fails++; std::printf("FAIL power valid\n"); }
  }

  // tower-base supply box packet: normal, then the worst case that must still fit
  SupData sd = {77, 14012, 13890, 14105, 1066, 412, 5980, 1, 214, 3600, "K2UA"};
  if (tlmFormatSupply(buf, sizeof(buf), &sd) <= 0) { fails++; std::printf("FAIL supply format\n"); }
  std::printf("%s", buf);
  sd = {78, 0, 0, 0, 0, 0, 0, 0, TLM_TEMP_NONE, 12, "K2UA"};
  tlmFormatSupply(buf, sizeof(buf), &sd);
  std::printf("%s", buf);
  {
    SupData worst = {65535, 65535, 65535, 65535, -40960, -40960, -40960, 1, -32768, 4294967295UL, "K2UA"};
    char big[TLM_MAX_LINE];
    int m = tlmFormatSupply(big, sizeof(big), &worst);
    if (m <= 0 || m > 80) { fails++; std::printf("FAIL worst-case supply length %d\n", m); }
    big[strcspn(big, "\r\n")] = 0;
    if (!tlmValid(big)) { fails++; std::printf("FAIL supply valid\n"); }
  }

  // validator on its own output and on corrupted copies
  buf[strcspn(buf, "\r\n")] = 0;
  if (!tlmValid(buf)) { fails++; std::printf("FAIL valid\n"); }
  buf[5] ^= 1;
  if (tlmValid(buf)) { fails++; std::printf("FAIL corrupt accepted\n"); }
  if (tlmValid("$RT,1,2*00")) { fails++; std::printf("FAIL bad checksum accepted\n"); }
  if (tlmValid("garbage")) { fails++; std::printf("FAIL garbage accepted\n"); }
  char tiny[20];
  if (tlmFormat(tiny, sizeof(tiny), &d) != 0) { fails++; std::printf("FAIL tiny buffer\n"); }

  // transverter reply relay: sanitise like the tower does, then split into parts
  const char *raw = "MKU 10 G5\r\nIF RX: 028 MHz, IF TX: 028 MHz\r\nRF RX $10368* RF TX 10368\r\nD1 50 D2 50 D3 50 D4 50\r\nREF PLL locked\r\n";
  char text[240];
  size_t n = 0;
  for (const char *p = raw; *p; p++) {
    char c = tlmReplyChar(*p);
    if (!c) continue;
    if (c == '|' && (n == 0 || text[n - 1] == '|')) continue;
    if (c == ' ' && n > 0 && text[n - 1] == ' ') continue;
    text[n++] = c;
  }
  while (n && text[n - 1] == '|') n--;
  unsigned total = (unsigned)((n + TLM_RK_TEXT - 1) / TLM_RK_TEXT);
  char line[TLM_RK_LINE];
  for (unsigned part = 0; part < total; part++) {
    size_t off = part * TLM_RK_TEXT;
    size_t len = n - off < TLM_RK_TEXT ? n - off : TLM_RK_TEXT;
    int m = tlmFormatReply(line, sizeof(line), 3, 's', part + 1, total, text + off, len, "K2UA");
    if (m <= 0) { fails++; std::printf("FAIL reply format\n"); break; }
    std::printf("%s", line);
    char chk[TLM_RK_LINE];
    memcpy(chk, line, m);
    chk[strcspn(chk, "\r\n")] = 0;
    if (!tlmValid(chk)) { fails++; std::printf("FAIL reply valid\n"); }
  }
  return fails;
}
