rusk2ua/remkey/(commit log)

2026-10-21 Add remtlm: tower-top telemetry over a 927 MHz LoRa link
    PA and transverter power sense (peak/avg), LO lock, PA heatsink temperature
    from a DS18B20, shown in the client (Ctrl-P, alerts, per-TX peak summary),
    logged to CSV, with a calibration table for watts.
    Claude-Session: https://claude.ai/code/session_01TnyWfJJkfveHsHjXFfc2LE
2026-10-21 remtlm: Kuhne MKU 10 G5 support
    Read-only polling of the MKU serial port (v at boot, s every minute) relayed
    as $RK packets; Ctrl-K shows them. LD (10 MHz ref lock) read on an analog pin
    because it is 3.3 V through 330 ohms. Second DS18B20 for the MKU case with its
    own alert threshold. README wiring for MKU CON1 pins 9/11/12/15/16.
    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
2026-10-21 Make the repo GitHub-ready
    CI (Python 3.11/3.13 on Linux, Windows, macOS; firmware simulation; arduino-cli
    builds of all four Nano images with .hex artifacts), ruff lint config, CHANGELOG,
    CONTRIBUTING, SECURITY, issue template, .gitattributes, README badges, status
    and quick start. Host package 0.2.0.
    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
    [client.py, serial_link.py, station.py, telemetry.py]
2026-10-21 Fix Arduino build: declare keyer enums in a header
    arduino-cli generates function prototypes near the top of the sketch, before
    the enums used in startPaddleElement()/chooseNext() signatures, so the remkey
    client and station builds failed in CI. Moving TState/PState/Elem into
    keyer_types.h makes them visible to the generated prototypes.
    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
    [keyer_types.h, remkey.ino]
2026-10-21 Add tower supply voltage and current monitoring (INA226)
    remtlm 0.3.0: INA226 on I2C with a 2 mOhm high-side shunt at the enclosure
    entry; min/max/average voltage and current per interval sent as $RP packets.
    Host 0.3.0: supply readings in the client (Ctrl-V, Ctrl-P, after-TX summary),
    alerts for low/high voltage, high/low current and INA226 failure, CSV columns.
    The station fits V = Vsupply - R*I from the readings to measure the cable's loop
    resistance and the voltage held at the base, with a wire-gauge check.
    New: python -m remkey.powerstats for RX/TX statistics and suggested limits.
    README: correct the 927 MHz link to Part 97 (not Part 15).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
    [client.py, config.h, config.py, powerstats.py, remtlm.ino, station.py, telemetry.py]
2026-10-25 Default to a 20 A / 75 mV panel-meter shunt (3.75 mOhm)
    SHUNT_UOHM 3750: 21.8 A full scale, 0.67 mA steps. README wiring shows the
    bolt and sense-screw (Kelvin) connections and notes the shunt is live at
    +13.8 V. Build plan updated.
    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
2026-10-25 remkey 0.2.0: on-board LED flashes with sent CW; PTT LED moves to D12
    The on-board LED (D13) now follows every keyed element on both roles (paddle on
    the client, re-keyed text on the station), with LED_ACTIVE_LOW (default 1) for
    clones whose LED lights on LOW. PTT state moves to an optional external LED on
    D12. Simulation adds an LED test and runs both polarities.
    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
2026-10-25 Graceful PTT release: finish queued CW, then hold PTT 2 s
    remkey firmware 0.3.0: P:0 now keys out queued CW and holds PTT for
    PTT_HANG_MS (2 s, settable with J:<ms>); CW arriving during the hold is keyed
    and restarts it, so PTT never drops while CW is being sent. O drops PTT at
    once; the watchdog stays immediate. The Nano reports actual PTT changes
    (P:1/P:0). The client Nano reports a just-finished character before B:P.
    Host 0.4.0: station uses the graceful release (ptt_hang_ms in station.toml),
    O for safety stops, and the Nano's reports for PTT state; Esc during a release
    drops PTT at once. Fixes a race where a late P:1 report cancelled a release.
    Client shows 'releasing', PTT during a rel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
    [client.py, config.h, config.py, remkey.ino, serial_link.py, sim_test.cpp, station.py]
2026-10-26 Fix spurious station watchdog; add latching PTT switch support
    remkey firmware 0.4.0:
    - Station watchdog compared now - lastRxMs unsigned. lastRxMs is stamped
    with millis() inside serviceSerial(), which can be a tick later than the
    loop's `now`, so the difference wrapped to ~4.29e9 and dropped PTT with
    !:WDOG right after a fresh heartbeat. CW traffic made it frequent. Now a
    signed comparison, with a sim regression test that fails on 0.3.0.
    - PTT input reports B:P on close, B:R on open, and B:H at power-up if
    already closed (no phantom press).
    Host package 0.5.0:
    - Client ptt_switch = "latching" for an SPST toggle: PTT follows the
    switch, OFF is the graceful release; after a safe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
    [client.py, config.py, remkey.ino, sim_test.cpp, station.py]
2026-10-26 Stream long dash runs as zeros instead of holding them until release
    remkey firmware 0.4.1 (client Nano). A held dah paddle never produces the
    2-dit gap that ends a character, so a run of dashes sat in the decoder
    until the paddle was released and was then cut to MAX_PAT (10) elements:
    nothing reached the station while peaking an antenna, and a long run went
    out as only 10 dashes.
    When a 6th dah follows "-----" the five are emitted as 0 and the run
    continues (0 is the longest all-dah character, so this loses nothing);
    the leftover goes out as an ordinary character on release. Any other run
    that fills the pattern buffer is emitted raw and continues, replacing the
    silent truncation. Station f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
2026-10-27 Docs: run Tailscale inside NordVPN; excluding tailscaled cuts it off
    Tested on the shack PC: NordVPN's per-app split tunneling, applied to the
    Tailscale service, leaves it unable to reach the control server after a
    restart. Keep tailscaled inside the tunnel; Plan B (VPN for selected apps
    only) remains as an untested option if relayed latency matters.
    Claude-Session: https://claude.ai/code/session_01UT9WmiyzuDRZsy626Ei5qP
2026-10-27 Docs: tailscale ping behavior and measured relay vs direct latency
    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
2026-10-27 Build plan: antennas from UT-141 semi-rigid
    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
2026-10-28 Add remkey.e220: check and program E220 modules via a USB serial adapter
    Reads and decodes an E220-900T22D's registers (C1 00 08) in configuration mode,
    or stores remtlm's settings (C0 00 08: channel 77, 9.6 kbps, 17 dBm,
    transparent, no encryption) and verifies the read-back. Tested against a
    simulated module on a pty. README section 9 gives FT232 wiring.
    Host 0.5.1 (remkey.__version__ now matches pyproject.toml).
    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
2026-10-30 Survive a keyer USB unplug: release PTT gracefully and reconnect
    SerialLink now reports a failed port as "#:LOST", drops writes while the
    port is gone, re-opens it every second, and reports "#:BACK" when it
    returns.
    Client: losing the travel keyer (and with it the PTT button) sends a
    graceful PTT-off, so queued CW is still keyed out before the hang. When
    the keyer is back, the client re-sends WPM, sidetone and the PTT LED.
    Station: losing the station Nano marks PTT off (the unpowered Nano has
    already opened both optos). When it is back, the service re-arms the
    watchdog, hang time and speed.
    Claude-Session: https://claude.ai/code/sess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
    [client.py, serial_link.py, station.py]
2026-10-30 Docs: end-to-end on the real station; PC817 board mods; SO2R+ PTT input
    README: status update, removing the four 302 resistors on 2-channel
    PC817 boards, the SO2R+ RCA PTT footswitch input, and keyer-unplug
    bench tests. Build plan: phases 1-3 ticked from the bench and on-air
    tests.
    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
2026-10-31 README: add client and station schematics, client wiring table
    - Client Nano: schematic (docs/img/client-nano-schematic.svg) and a pin
    table replacing the ASCII wiring block; ptt_switch values spelled out
    - Station Nano: keep the block diagram, add a schematic of the modified
    2-channel PC817 board (302s bridged, 220R drive, G-G jumper off) plus
    a terminal table
    - Parts: list the 220R drive resistors for the ready-made opto board
    - docs/img/make_schematics.py regenerates both drawings (schemdraw)
    Claude-Session: https://claude.ai/code/session_01UT9Wmj6DTQbFABD3ZbMmiQ
2026-10-31 README: schematics for tower telemetry (section 9)
    - E220 to Nano (both ends): 1k/2k dividers on M0, M1, RXD; TXD/AUX
    direct; 100 uF on VCC; antenna
    - Tower signals: PA sense and MKU MON dividers (10k/22k/100nF), LD with
    100k pull-down, MKU CON1 serial through the BSS138 shifter, DS18B20
    bus with 4.7k pull-up
    - Tower power: shunt with Kelvin sense to the INA226 (VBUS to IN-),
    I2C to A4/A5, 1 A fuse, 5 V buck, AMS1117-3.3
    - The ASCII wiring blocks stay; the schematics sit right after them
    - make_schematics.py: draws the new ones too, and its SVG output is now
    reproducible (fixed timestamp and IDs), so the keyer SVGs change once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
2026-11-12 remtlm: move PwrStats to tlm_proto.h (Arduino prototype order)
2026-11-13 Add telemetry web dashboard to the station service (host 0.7.0)
    Live telemetry page for another computer or tablet on the home network or
    Tailscale: supply box and tower-top readings, transverter status, history
    charts (reloaded from the CSV log after a restart) and the alert log, with
    harmless buttons (marker, reset min/max, clear list). Served by the station
    service itself over plain asyncio HTTP + Server-Sent Events, no new
    dependencies; nothing on the page can key the radio.
    Access: only dash_allow networks (default private ranges + Tailscale), only
    IP or plain machine/*.local/*.ts.net Host names, button presses need the
    page's own header. If the dashboard can't start, keying still come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
    [config.py, dashboard.py, station.py]
2026-11-13 Cloud copy of the telemetry dashboard: S3 + CloudFront (host 0.8.0)
    The station service can push telemetry snapshots to S3 (state every 15 s,
    1-hour history every minute, 12-hour history every 5 min) from a worker
    thread with short timeouts; failures are rate-limited in the log and never
    touch keying. The remote session (client address, PTT) is left out.
    The dashboard page gains a read-only cloud mode that polls the JSON files.
    cloud/template.yaml + cloud/deploy.sh (run from the Mac) build a private
    bucket behind CloudFront with an ACM cert, a CloudFront Function for the
    password prompt and a secret path for Claude, Route 53 records, and an IAM
    user that can only write data/. CI lints the t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
    [cloud.py, config.py, dashboard.py, station.py]
2026-11-14 Cloud copy: summary.html for Claude, Install-remkey.bat, clearer boto3 error (host 0.8.1)
    - Upload data/summary.html every 60 s: plain, script-free current readings and
    recent alerts that Claude's web fetch can read (it won't read the JSON).
    - host\Install-remkey.bat [cloud] installs into the same Python as
    Start-remkey.bat (host\.venv if present); README uses it instead of py -m pip,
    which missed the venv and left boto3 out of the station's Python.
    - The boto3-missing error names sys.executable and the fix.
    - pyproject: SPDX license string, list remkey.web (no setuptools warnings).
    Claude-Session: https://claude.ai/code/session_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
    [cloud.py]
2026-11-14 Docs: run .\Install-remkey.bat (PowerShell needs the .\ prefix)
    Claude-Session: https://claude.ai/code/session_01UT9WmjDP4GTw55uUrUFHCd
